ttaqinmu/turnstile-gate/(list of files, cad)

Other CAD files:
hardware.blend
