ttaqinmu/turnstile-gate/kicad/control-board/control-board.kicad_pcb

## KiCad design kicad/control-board/control-board.kicad_pcb (2026-10-16)

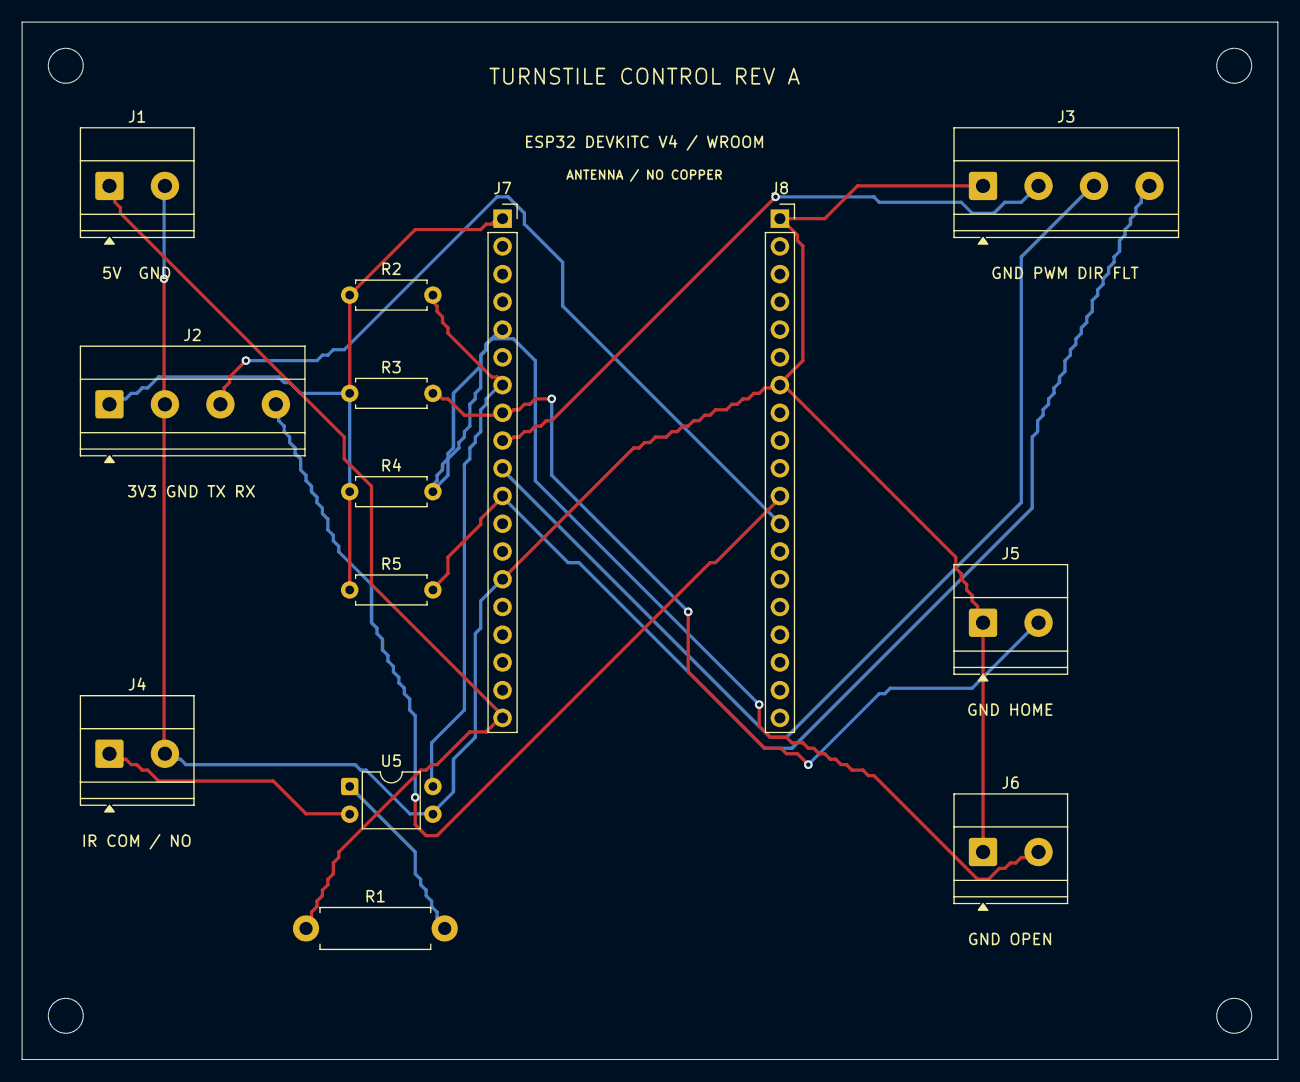
[picture p1: board control-board.kicad_pcb from above]

Board: 2 copper layers, 115.0 x 95.0 mm, 18 parts (0 on the bottom side), 13 nets.

Parts:
H1, H2, H3, H4: M3; MountingHole_3.2mm_M3
J1: 5V BUCK; TerminalBlock_Phoenix_MKDS-1,5-2-5.08_1x02_P5.08mm_Horizont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
J2: QR UART; TerminalBlock_Phoenix_MKDS-1,5-4-5.08_1x04_P5.08mm_Horizont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
J3: MOTOR DRIVER LOGIC; TerminalBlock_Phoenix_MKDS-1,5-4-5.08_1x04_P5.08mm_Horizont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
J4: IR RELAY COM NO; TerminalBlock_Phoenix_MKDS-1,5-2-5.08_1x02_P5.08mm_Horizont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
J5: LIMIT HOME NC; TerminalBlock_Phoenix_MKDS-1,5-2-5.08_1x02_P5.08mm_Horizont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
J6: LIMIT OPEN NC; TerminalBlock_Phoenix_MKDS-1,5-2-5.08_1x02_P5.08mm_Horizont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
J7: ESP32 J2; PinSocket_1x19_P2.54mm_Vertical
J8: ESP32 J3; PinSocket_1x19_P2.54mm_Vertical
R1: 330R 0.5W; R_Axial_DIN0411_L9.9mm_D3.6mm_P12.70mm_Horizontal
R2: 10k IR; R_Axial_DIN0207_L6.3mm_D2.5mm_P7.62mm_Horizontal
R3: 10k HOME; R_Axial_DIN0207_L6.3mm_D2.5mm_P7.62mm_Horizontal
R4: 10k OPEN; R_Axial_DIN0207_L6.3mm_D2.5mm_P7.62mm_Horizontal
R5: 10k FLT; R_Axial_DIN0207_L6.3mm_D2.5mm_P7.62mm_Horizontal
U5: PC817; DIP-4_W7.62mm

Connections:
+3V3: J2.1, J7.1, R2.1, R3.1, R4.1, R5.1
+5V: J1.1, J7.19, R1.1
DIR26: J3.3, J7.10
FLT27: J3.4, J7.11, R5.2
GND: J1.2, J2.2, J3.1, J4.2, J5.1, J6.1, J7.14, J8.1, J8.7, U5.3
HOME33: J5.2, J7.8, R3.2
IR32: J7.7, R2.2, U5.4
IR_COM: J4.1, U5.2
OPEN34: J6.2, J7.5, R4.2
OPTO_ANODE: R1.2, U5.1
PWM25: J3.2, J7.9
QR_RX: J2.4, J8.11
QR_TX: J2.3, J8.12
